Cryptoblade9623/Gamepad/README.md

# Gamepad
This is a keyboard with only 27 keys. It was designed for gaming, so only the keys that I need for games are included.
It has per-key RGB, and you can cycle through different animations with some combos I made.
It has a rotary encoder for volume control, and to mute something.
I am reusing many of the parts that I already have, so I will not include them in the BOM.
It is controlled and coded with CircuitPython with KMK and a Waveshare RP2040 Zero.
The files in the Files folder contain everything you need to make or edit it, like KiCad and Fusion 360 source files, Gerbers and firmware.







## BOM
| Item | Qty | Supplier | Cost/item | Total Cost | link |
|---|-----|---|---|---|---|
| Waveshare RP2040 Zero | 1 | AliExpress | $3.22 | $3.22 | https://www.aliexpress.com/item/1005008738491752.html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 |
| SK6812 MINI E | 1 | AliExpress | $3.89 | $3.89 | https://www.aliexpress.com/item/1005007804788253.html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 |
| Custom PCB | 1 | JLCPCB | $10.90 | $10.90 | https://cart.jlcpcb.com/shopcart/cart/ |
| 1N4148 Diodes | 1 | AliExpress | $1.19 | $1.19 | https://www.aliexpress.com/item/1005007536719404.html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 |
| USBC Breakout Board | 1 | AliExpress | $1.13 | $1.13 | https://www.aliexpress.com/item/1005012011244259.html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 |
| Stabilizers | 1 | AliExpress | $4.51 | $4.51 | https://www.aliexpress.com/item/1005002003442544.html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 |
| Rubber Feet | 1 | AliExpress | $1.23 | $1.23 | https://www.aliexpress.com/item/1005005828846290.html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 |
| Estimated total shipping | | | | $6.66 | |
| Grand Total | | | | $32.73 | |
