Cryptoblade9623/Gamepad/BOM.csv

Item | Qty | Supplier | Cost/item | Total Cost | link
Waveshare RP2040 Zero | 1 | AliExpress | $3.22 | $3.22 | https://www.aliexpress.com/item/1005008738491752.html?curPageLogUid=lCmdrrr83lyW
SK6812 MINI E | 1 | AliExpress | $3.89 | $3.89 | https://www.aliexpress.com/item/1005007804788253.html?curPageLogUid=SlNEr6LLqNnO
Custom PCB | 1 | JLCPCB | $10.90 | $10.90 | https://cart.jlcpcb.com/shopcart/cart/
1N4148 Diodes | 1 | AliExpress | $1.19 | $1.19 | https://www.aliexpress.com/item/1005007536719404.html
USBC Breakout Board | 1 | AliExpress | $1.13 | $1.13 | https://www.aliexpress.com/item/1005012011244259.html?curPageLogUid=zSV1yswovQO5
Stabilizers | 1 | AliExpress | $4.51 | $4.51 | https://www.aliexpress.com/item/1005002003442544.html?curPageLogUid=jusW35DST7r5
Rubber Feet | 1 | AliExpress | $1.23 | $1.23 | https://www.aliexpress.com/item/1005005828846290.html?scm_id=1007.40050.354490.0&scm-url=1007.40050.354490.0
Estimated total shipping | 1 |  |  | $6.66
