Cryptoblade9623/Gamepad/Files/3D Files/Gamepad PCB.step

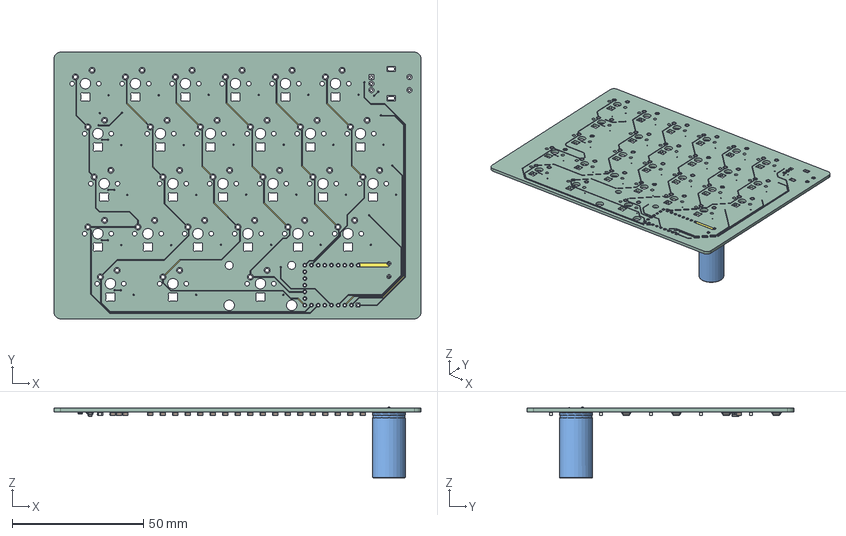
[picture p1: CAD file, 2026-11-06]
Files/3D Files/Gamepad PCB.step
139.8 x 101.6 x 27.0 mm
D_SOD-123 x 27
C_0805_2012Metric x 28
R_1206_3216Metric
SOT-23-5
C_Radial_D125mm_H250mm_P500mm
Gam7DCC_copper
Gam7DCC_pad
Gam7DCC_via
Gam7DCC_PCB
