Cryptoblade9623/Gamepad/Files/3D Files/Gamepad.step

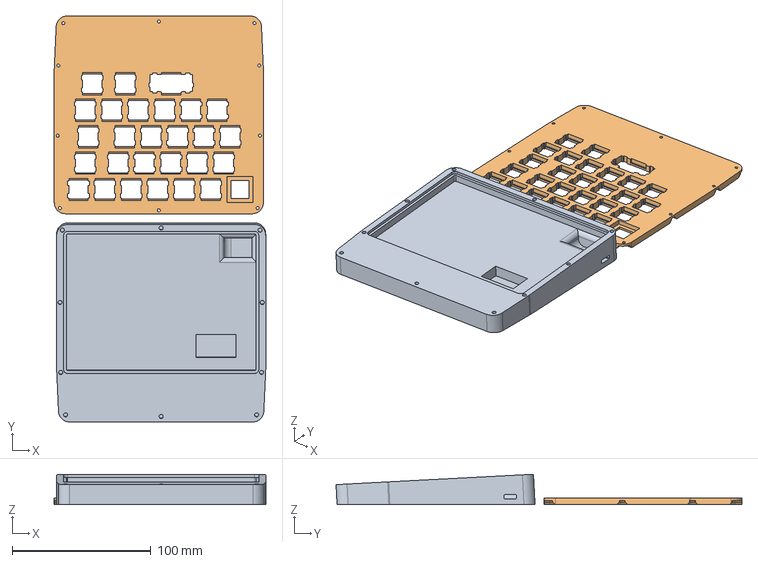
[picture p2: CAD file, 2026-11-06]
Files/3D Files/Gamepad.step
152.5 x 292.7 x 22.0 mm
