Cryptoblade9623/Gamepad/(list of files, cad)

Other CAD files:
Files/3D Files/Gamepad.f3d
Files/3D Files/Gamepad.stl
