Cryptoblade9623/Gamepad/Files/KiCad/Gamepad.kicad_pcb

## KiCad design Files/KiCad/Gamepad.kicad_pcb (2026-11-06)

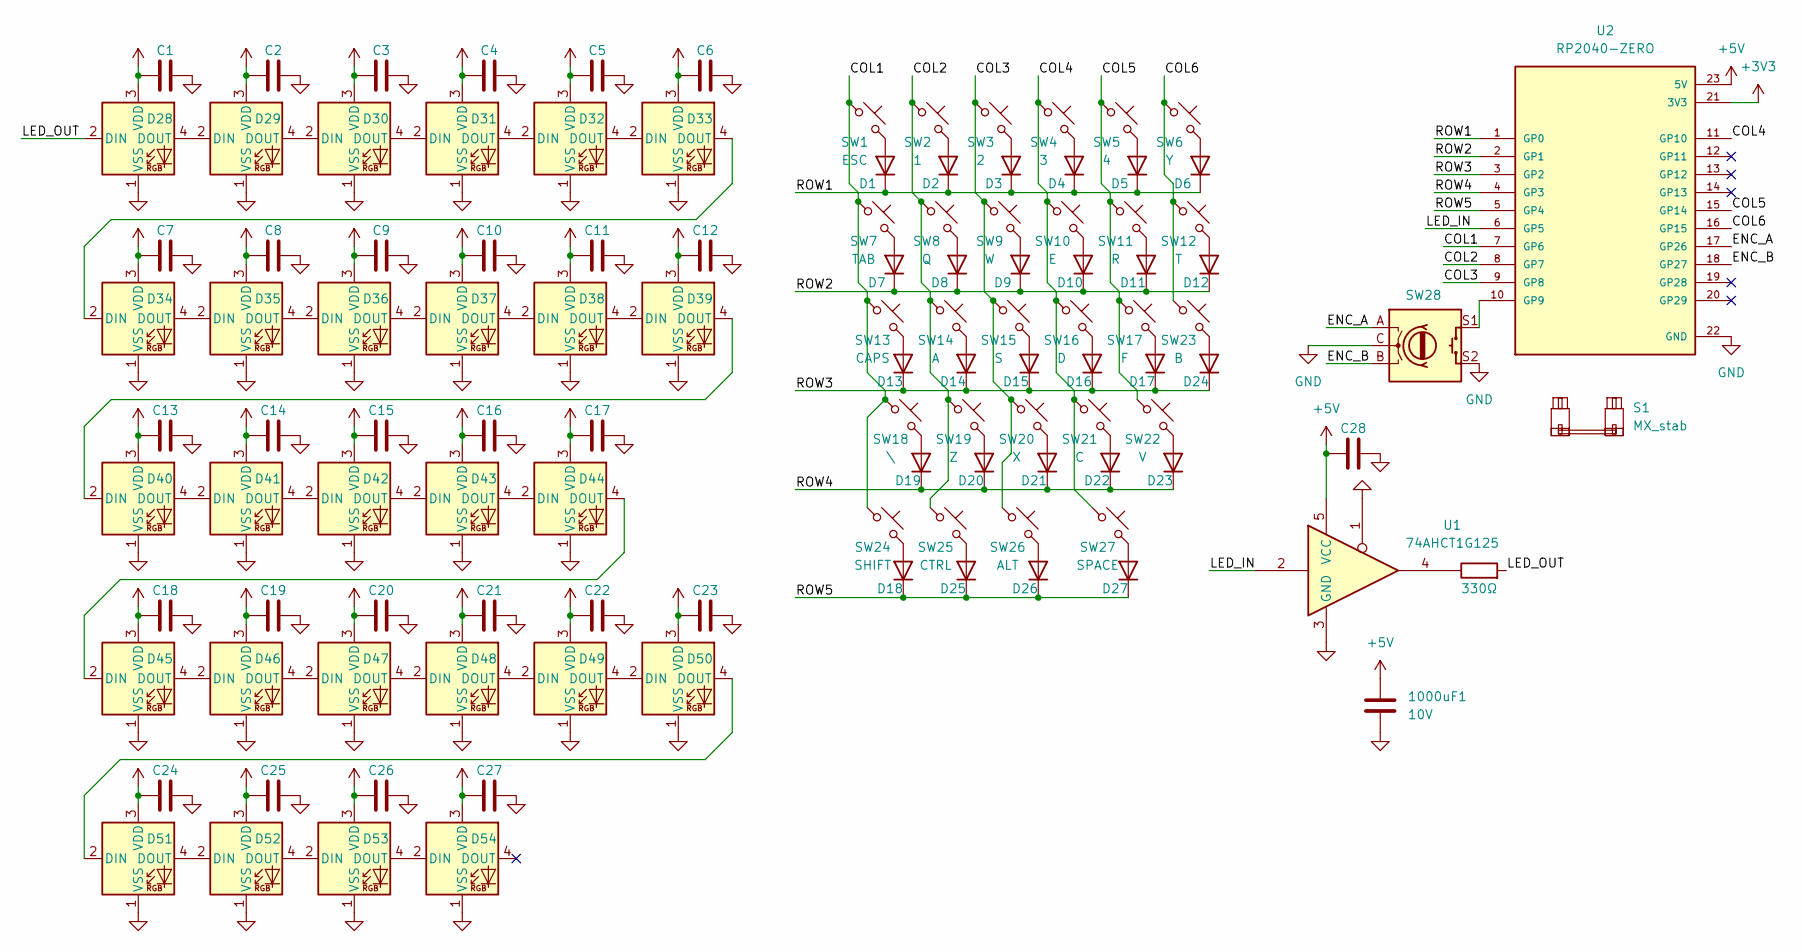
[picture p3: schematic Gamepad.kicad_sch]

Parts:
1000uF1: 10V; C_Radial_D12.5mm_H25.0mm_P5.00mm
C1, C2, C3, C4, C5, C6, C7, C8, C9, C10, C11, C12, C13, C14, C15, C16, C17, C18, C19, C20, C21, C22, C23, C24, C25, C26, C27, C28: C; C_0805_2012Metric_Pad1.18x1.45mm_HandSolder
D1, D2, D3, D4, D5, D6, D7, D8, D9, D10, D11, D12, D13, D14, D15, D16, D17, D18, D19, D20, D21, D22, D23, D24, D25, D26, D27: D; D_SOD-123
D28, D29, D30, D31, D32, D33, D34, D35, D36, D37, D38, D39, D40, D41, D42, D43, D44, D45, D46, D47, D48, D49, D50, D51, D52, D53, D54: SK6812MINI-E; LED_MX_6028R
R1: 330Ω; R_1206_3216Metric_Pad1.30x1.75mm_HandSolder
S1: MX_stab; STAB_MX_2.25u
SW1: ESC; SW_MX_1u
SW2: 1; SW_MX_1u
SW3: 2; SW_MX_1u
SW4: 3; SW_MX_1u
SW5: 4; SW_MX_1u
SW6: Y; SW_MX_1u
SW7: TAB; SW_MX_1.5u
SW8: Q; SW_MX_1u
SW9: W; SW_MX_1u
SW10: E; SW_MX_1u
SW11: R; SW_MX_1u
SW12: T; SW_MX_1u
SW13: CAPS; SW_MX_1.75u
SW14: A; SW_MX_1u
SW15: S; SW_MX_1u
SW16: D; SW_MX_1u
SW17: F; SW_MX_1u
SW18: \; SW_MX_1u
SW19: Z; SW_MX_1u
SW20: X; SW_MX_1u
SW21: C; SW_MX_1u
SW22: V; SW_MX_1u
SW23: B; SW_MX_1u
SW24: SHIFT; SW_MX_1u
SW25: CTRL; SW_MX_1.25u
SW26: ALT; SW_MX_1.25u
SW27: SPACE; SW_MX_1u
SW28: RotaryEncoder_Switch; RotaryEncoder_Alps_EC11E-Switch_Vertical_H20mm
U1: 74AHCT1G125; SOT-23-5_HandSoldering
U2: RP2040-ZERO; MODULE_RP2040-ZERO; PARTREV NA

Connections:
+3V3: U2.21 (3V3)
+5V: 1000uF1.1, C1.1, C2.1, C3.1, C4.1, C5.1, C6.1, C7.1, C8.1, C9.1, C10.1, C11.1, C12.1, C13.1, C14.1, C15.1, C16.1, C17.1, C18.1, C19.1, C20.1, C21.1, C22.1, C23.1, C24.1, C25.1, C26.1, C27.1, C28.1, D28.3 (VDD), D29.3 (VDD), D30.3 (VDD), D31.3 (VDD), D32.3 (VDD), D33.3 (VDD), D34.3 (VDD), D35.3 (VDD), D36.3 (VDD), D37.3 (VDD), D38.3 (VDD), D39.3 (VDD), D40.3 (VDD), D41.3 (VDD), D42.3 (VDD), D43.3 (VDD), D44.3 (VDD), D45.3 (VDD), D46.3 (VDD), D47.3 (VDD), D48.3 (VDD), D49.3 (VDD), D50.3 (VDD), D51.3 (VDD), D52.3 (VDD), D53.3 (VDD), D54.3 (VDD), U1.5 (VCC), U2.23 (5V)
/COL1: SW1.1, SW7.1, SW13.1, SW18.1, SW24.1, U2.7 (GP6)
/COL2: SW2.1, SW8.1, SW14.1, SW19.1, SW25.1, U2.8 (GP7)
/COL3: SW3.1, SW9.1, SW15.1, SW20.1, SW26.1, U2.9 (GP8)
/COL4: SW4.1, SW10.1, SW16.1, SW21.1, SW27.1, U2.11 (GP10)
/COL5: SW5.1, SW11.1, SW17.1, SW22.1, U2.15 (GP14)
/COL6: SW6.1, SW12.1, SW23.1, U2.16 (GP15)
/ENC_A: SW28.A, U2.17 (GP26)
/ENC_B: SW28.B, U2.18 (GP27)
/LED_IN: U1.2, U2.6 (GP5)
/LED_OUT: D28.2 (DIN), R1.2
/ROW1: D1.1 (K), D2.1 (K), D3.1 (K), D4.1 (K), D5.1 (K), D6.1 (K), U2.1 (GP0)
/ROW2: D7.1 (K), D8.1 (K), D9.1 (K), D10.1 (K), D11.1 (K), D12.1 (K), U2.2 (GP1)
/ROW3: D13.1 (K), D14.1 (K), D15.1 (K), D16.1 (K), D17.1 (K), D24.1 (K), U2.3 (GP2)
/ROW4: D19.1 (K), D20.1 (K), D21.1 (K), D22.1 (K), D23.1 (K), U2.4 (GP3)
/ROW5: D18.1 (K), D25.1 (K), D26.1 (K), D27.1 (K), U2.5 (GP4)
GND: 1000uF1.2, C1.2, C2.2, C3.2, C4.2, C5.2, C6.2, C7.2, C8.2, C9.2, C10.2, C11.2, C12.2, C13.2, C14.2, C15.2, C16.2, C17.2, C18.2, C19.2, C20.2, C21.2, C22.2, C23.2, C24.2, C25.2, C26.2, C27.2, C28.2, D28.1 (VSS), D29.1 (VSS), D30.1 (VSS), D31.1 (VSS), D32.1 (VSS), D33.1 (VSS), D34.1 (VSS), D35.1 (VSS), D36.1 (VSS), D37.1 (VSS), D38.1 (VSS), D39.1 (VSS), D40.1 (VSS), D41.1 (VSS), D42.1 (VSS), D43.1 (VSS), D44.1 (VSS), D45.1 (VSS), D46.1 (VSS), D47.1 (VSS), D48.1 (VSS), D49.1 (VSS), D50.1 (VSS), D51.1 (VSS), D52.1 (VSS), D53.1 (VSS), D54.1 (VSS), SW28.C, SW28.S2, U1.1, U1.3 (GND), U2.22 (GND)
unnamed: D1.2 (A), SW1.2
unnamed: D2.2 (A), SW2.2
unnamed: D3.2 (A), SW3.2
unnamed: D4.2 (A), SW4.2
unnamed: D5.2 (A), SW5.2
unnamed: D6.2 (A), SW6.2
unnamed: D7.2 (A), SW7.2
unnamed: D8.2 (A), SW8.2
unnamed: D9.2 (A), SW9.2
unnamed: D10.2 (A), SW10.2
unnamed: D11.2 (A), SW11.2
unnamed: D12.2 (A), SW12.2
unnamed: D13.2 (A), SW13.2
unnamed: D14.2 (A), SW14.2
unnamed: D15.2 (A), SW15.2
unnamed: D16.2 (A), SW16.2
unnamed: D17.2 (A), SW17.2
unnamed: D18.2 (A), SW24.2
unnamed: D19.2 (A), SW18.2
unnamed: D20.2 (A), SW19.2
unnamed: D21.2 (A), SW20.2
unnamed: D22.2 (A), SW21.2
unnamed: D23.2 (A), SW22.2
unnamed: D24.2 (A), SW23.2
unnamed: D25.2 (A), SW25.2
unnamed: D26.2 (A), SW26.2
unnamed: D27.2 (A), SW27.2
unnamed: D28.4 (DOUT), D29.2 (DIN)
unnamed: D29.4 (DOUT), D30.2 (DIN)
unnamed: D30.4 (DOUT), D31.2 (DIN)
unnamed: D31.4 (DOUT), D32.2 (DIN)
unnamed: D32.4 (DOUT), D33.2 (DIN)
unnamed: D33.4 (DOUT), D34.2 (DIN)
unnamed: D34.4 (DOUT), D35.2 (DIN)
unnamed: D35.4 (DOUT), D36.2 (DIN)
unnamed: D36.4 (DOUT), D37.2 (DIN)
unnamed: D37.4 (DOUT), D38.2 (DIN)
unnamed: D38.4 (DOUT), D39.2 (DIN)
unnamed: D39.4 (DOUT), D40.2 (DIN)
unnamed: D40.4 (DOUT), D41.2 (DIN)
unnamed: D41.4 (DOUT), D42.2 (DIN)
unnamed: D42.4 (DOUT), D43.2 (DIN)
unnamed: D43.4 (DOUT), D44.2 (DIN)
unnamed: D44.4 (DOUT), D45.2 (DIN)
unnamed: D45.4 (DOUT), D46.2 (DIN)
unnamed: D46.4 (DOUT), D47.2 (DIN)
unnamed: D47.4 (DOUT), D48.2 (DIN)
unnamed: D48.4 (DOUT), D49.2 (DIN)
unnamed: D49.4 (DOUT), D50.2 (DIN)
unnamed: D50.4 (DOUT), D51.2 (DIN)
unnamed: D51.4 (DOUT), D52.2 (DIN)
unnamed: D52.4 (DOUT), D53.2 (DIN)
unnamed: D53.4 (DOUT), D54.2 (DIN)
unnamed: R1.1, U1.4
unnamed: SW28.S1, U2.10 (GP9)

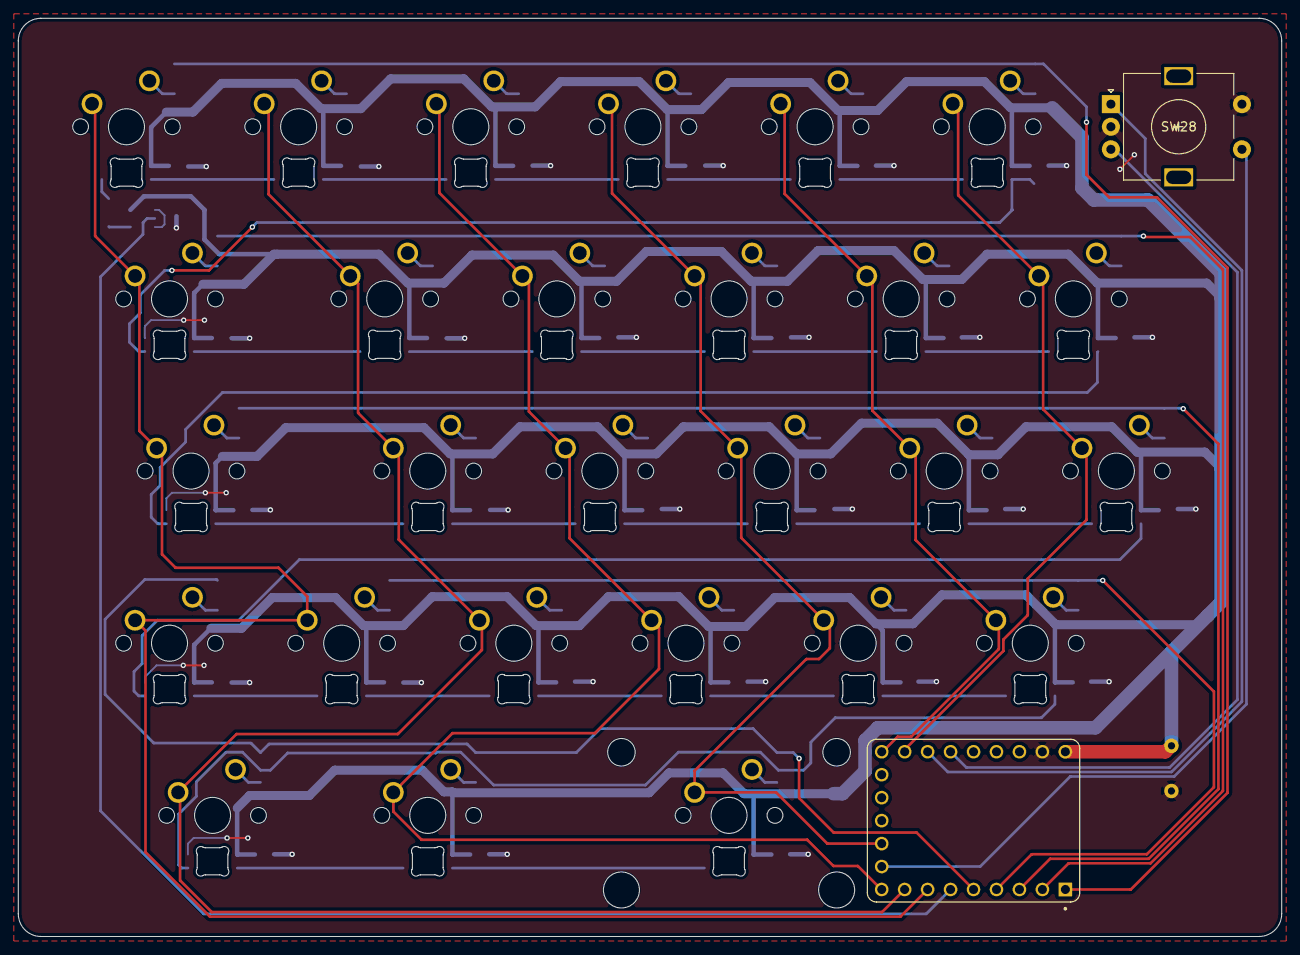
[picture p4: board Gamepad.kicad_pcb from above]

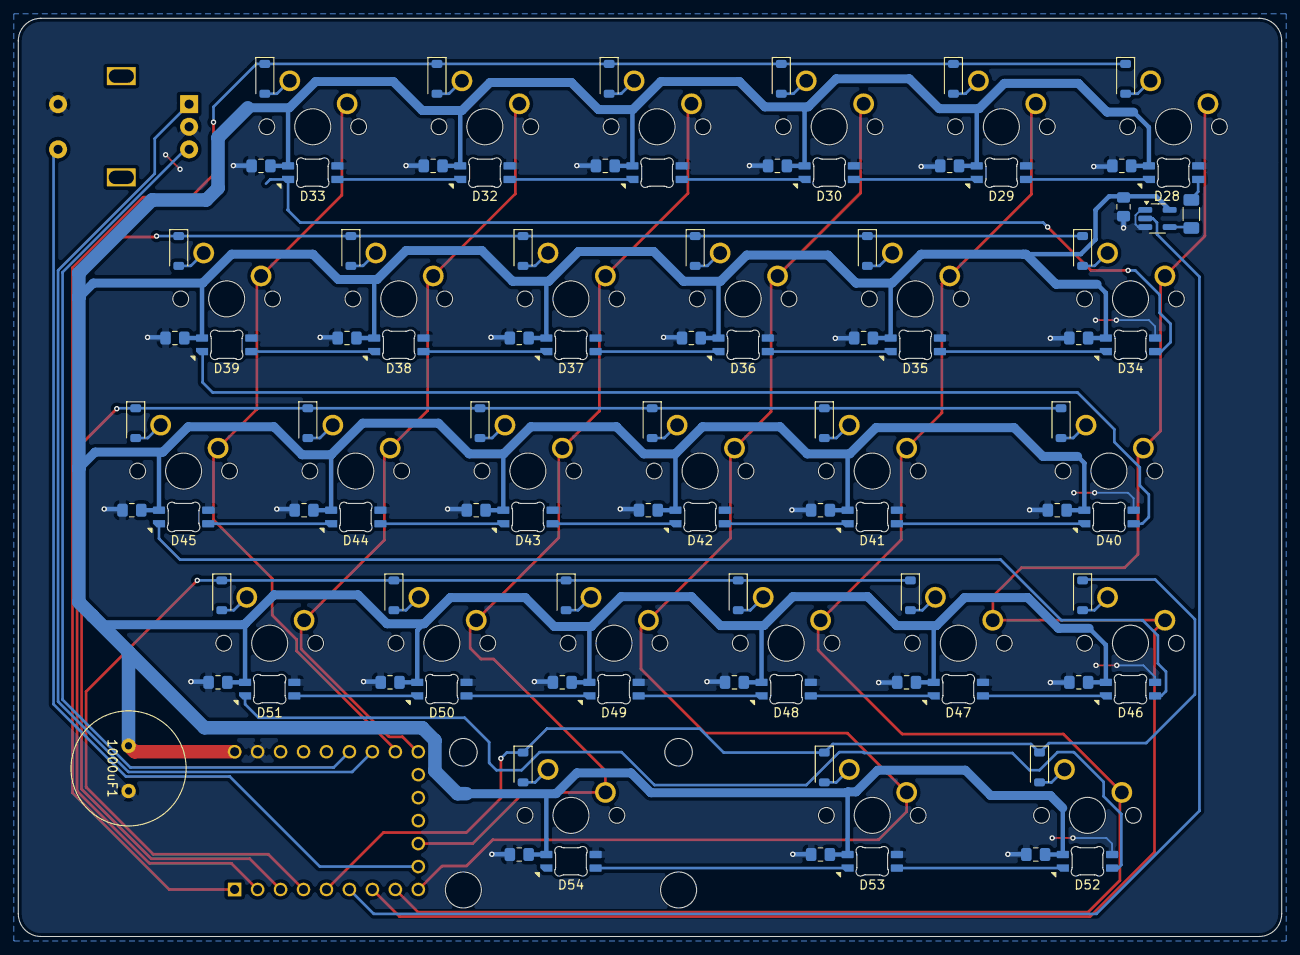
[picture p5: board Gamepad.kicad_pcb from below]

Board: 2 copper layers, 139.8 x 101.6 mm, 115 parts (85 on the bottom side), 72 nets.
