Cryptoblade9623/Gamepad/JOURNAL.md

# Gamepad: devlog

<!-- Generated by Half Life from project tftrrahdb00i830vmv5zz0qd. Edits here are overwritten on the next sync. -->
<!-- Generated: 2026-11-07T14:23:56.388Z -->

> [!NOTE]
> This devlog is mirrored from [Half Life](https://halflife.hackclub.com) ([open the project](https://halflife.hackclub.com/projects/tftrrahdb00i830vmv5zz0qd)). Editing it here will not change the platform's copy, and the next sync overwrites this file.

> A one handed keyboard for gaming ( Valorant ). It has per-key RGB and is unlike some of my other projects, it is not battery powered, to save money. It is a mechanical keyboard with KMK and circuit python. I will be using quite a few left over / extra parts from week 4 so they will not be included in the BOM ( capacitors, resistors, level shifter ) and neither will the switches because I will buy them myself.

| Week | Tier | Hours logged | Entries |
| --- | --- | --- | --- |
| Week 5 | Tier 1 | 9.21h | 6 |

## Contents

1. [2026-11-02: Work session](#2026-11-02-work-session)
2. [2026-11-04: Work session](#2026-11-04-work-session)
3. [2026-11-04: Work session](#2026-11-04-work-session)
4. [2026-11-05: Work session](#2026-11-05-work-session)
5. [2026-11-06: I wrote the code for the gamepad. The keyboard is a 5x6 matrix with some spaces so there are only 27 keys. There is RGB and you can skip through or toggle on and off using some combos I made. The enco](#2026-11-06-i-wrote-the-code-for-the-gamepad-the-keyboard-is-)
6. [2026-11-07: Work session](#2026-11-07-work-session)

## Design

### 2026-11-02: Work session

**2.4h**

[Timelapse](https://lookout.hackclub.com/api/media/feff9647-de4e-464a-86fd-36e642572303/video.mp4)

### 2026-11-04: Work session

**2.33h**

[Timelapse](https://lookout.hackclub.com/api/media/ffba6cec-8599-4cf9-b72c-6fcf2692cb88/video.mp4)

### 2026-11-04: Work session

**0.75h**

Work session

[Timelapse](https://lookout.hackclub.com/api/media/1496a8e0-f9cd-4617-8787-6a4f120406e5/video.mp4)

[Timelapse](https://lookout.hackclub.com/api/media/fe707927-de7f-474e-ba96-765bba6b2538/video.mp4)

### 2026-11-05: Work session

**1.18h**

[Timelapse](https://lookout.hackclub.com/api/media/9e81b844-021f-4457-859e-304786fe6f67/video.mp4)

### 2026-11-06: I wrote the code for the gamepad. The keyboard is a 5x6 matrix with some spaces so there are only 27 keys. There is RGB and you can skip through or toggle on and off using some combos I made. The enco

**2.23h**

I wrote the code for the gamepad. The keyboard is a 5x6 matrix with some spaces so there are only 27 keys. There is RGB and you can skip through or toggle on and off using some combos I made. The encoder is not part of the matrix so it has its own pin for the pushbutton as well, and it controls volume and can also mute.

[Timelapse](https://lookout.hackclub.com/api/media/35f84b10-f406-46c5-962a-2cad9054fc33/video.mp4)

### 2026-11-07: Work session

**0.32h**

[Timelapse](https://lookout.hackclub.com/api/media/9588eac1-d0de-464f-bb86-4e05305e095e/video.mp4)
