Cryptoblade9623/Gamepad/(commit log)

2026-11-06 Sync Gamepad from Half Life
    [BOM.csv]
2026-11-07 Add BOM section with item details and costs
    Added a Bill of Materials (BOM) section with item details, suppliers, costs, and links.
